huleg/ecstatic-epiphany/photos/2014-04-13 19.56.11.jpg

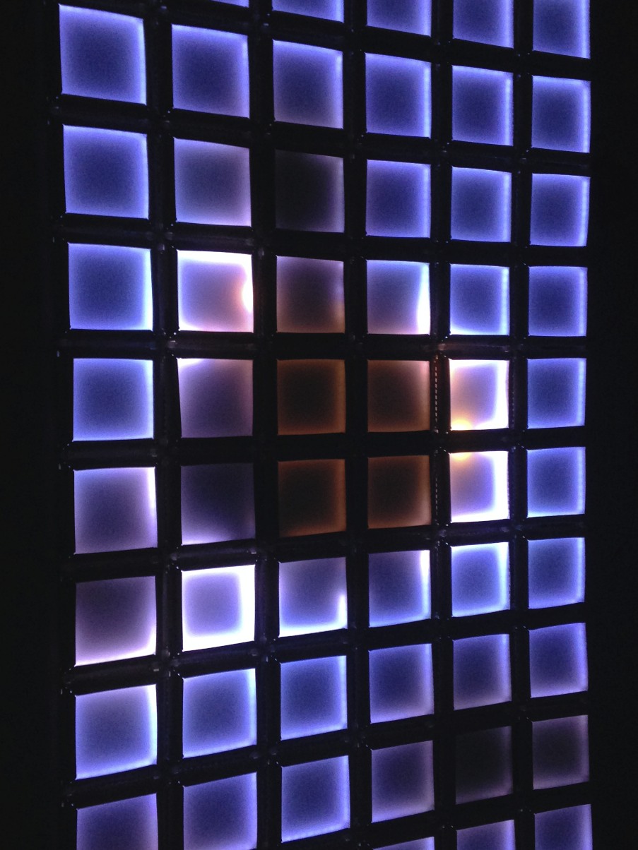
photos/2014-04-13 19.56.11.jpg
