huleg/ecstatic-epiphany/photos/2014-04-15 22.50.10.jpg

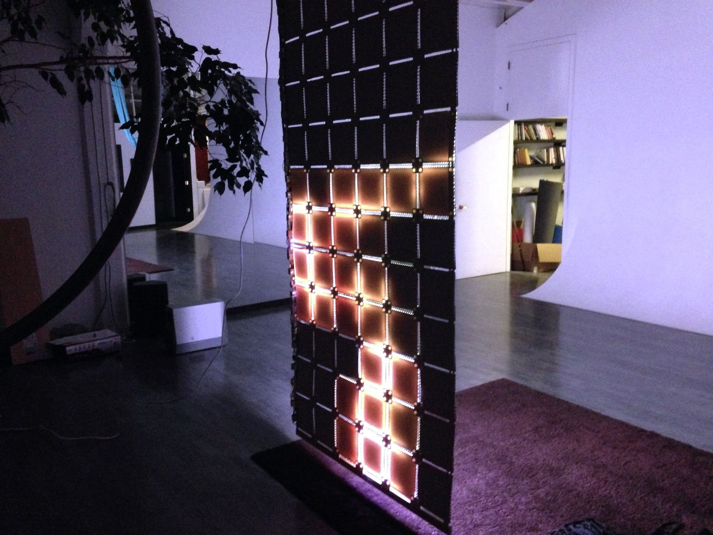
photos/2014-04-15 22.50.10.jpg
