huleg/ecstatic-epiphany/README.md

Ecstatic Epiphany
=================

An interactive light art installation.

2014, Micah Elizabeth Scott

Portfolio link: [misc.name/ecstatic-epiphany](http://www.misc.name/ecstatic-epiphany)
