huleg/ecstatic-epiphany/notes/2014-03-23 12.22.47.jpg

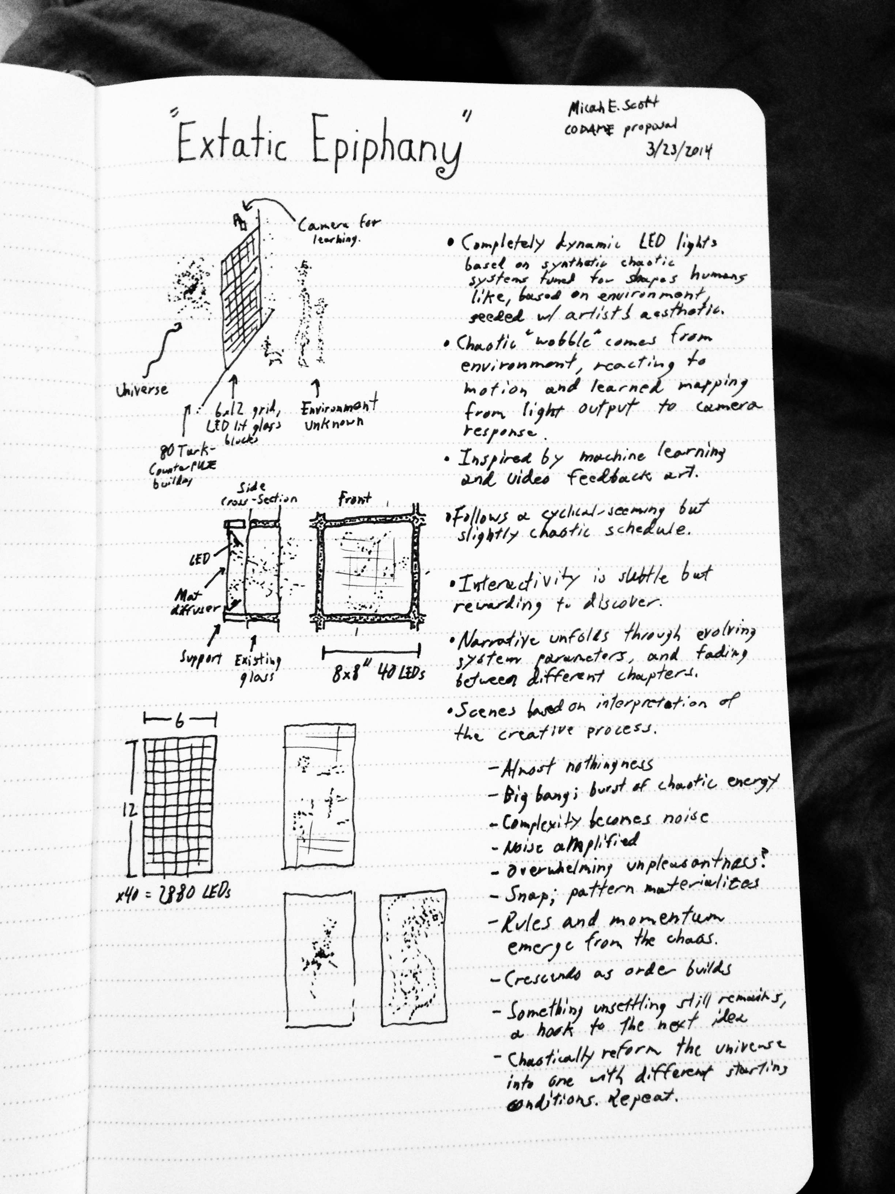
notes/2014-03-23 12.22.47.jpg
