huleg/ecstatic-epiphany/photos/2014-03-28 12.23.55.jpg

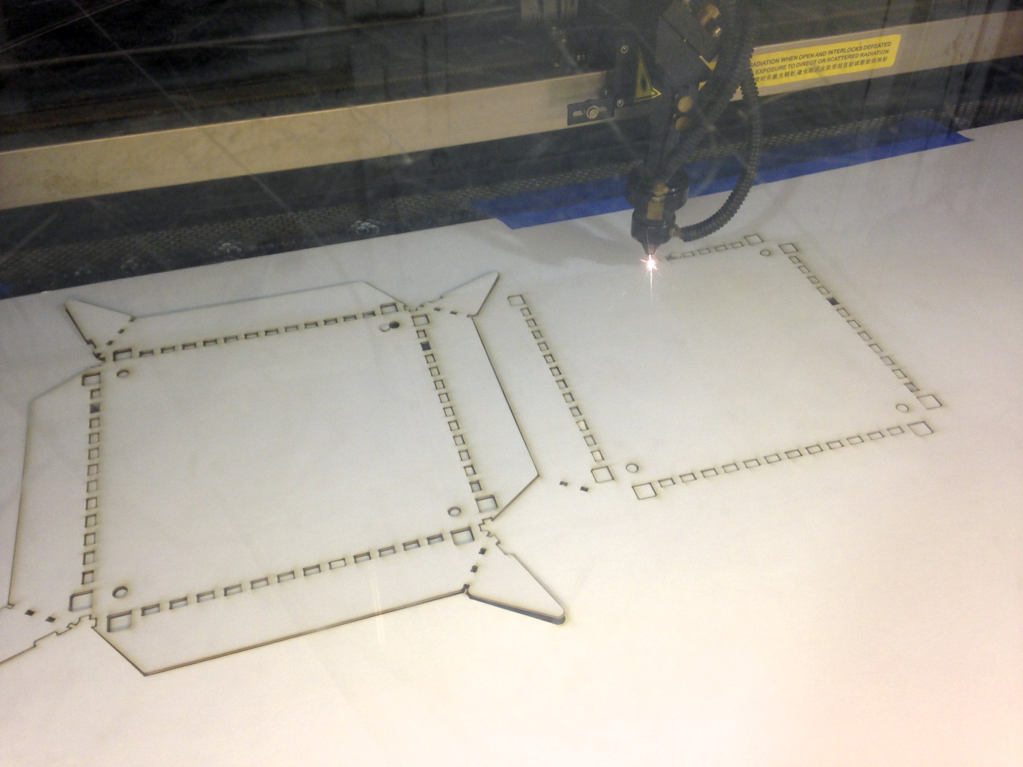
photos/2014-03-28 12.23.55.jpg
