huleg/ecstatic-epiphany/photos/2014-04-05 00.15.27.jpg

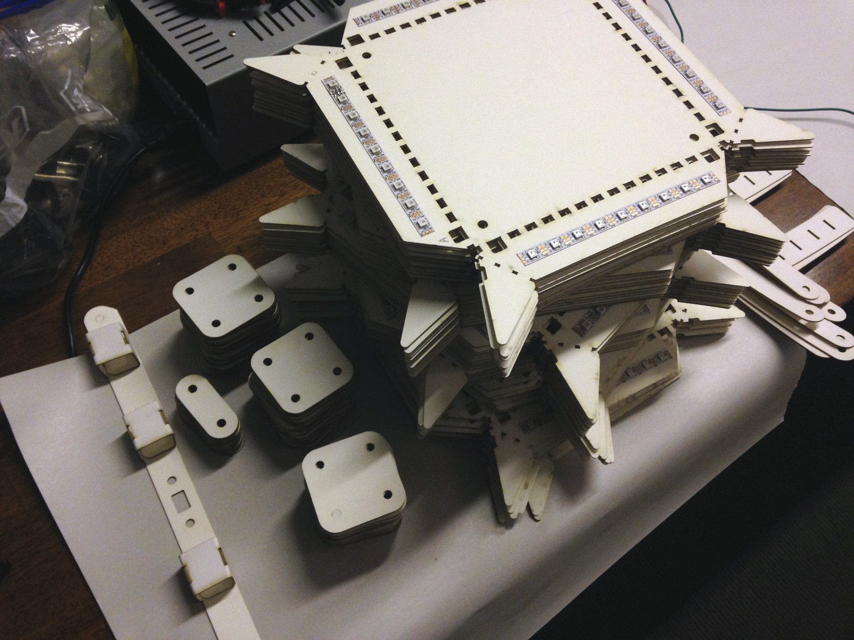
photos/2014-04-05 00.15.27.jpg
