huleg/ecstatic-epiphany/photos/2014-04-05 10.41.52.jpg

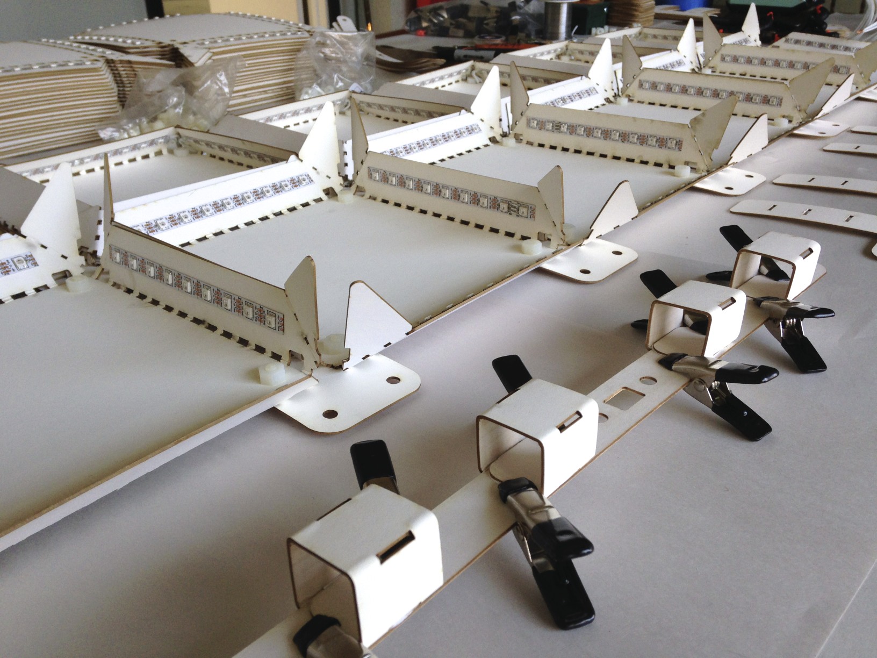
photos/2014-04-05 10.41.52.jpg
