huleg/ecstatic-epiphany/photos/2014-04-06 21.35.55 HDR.jpg

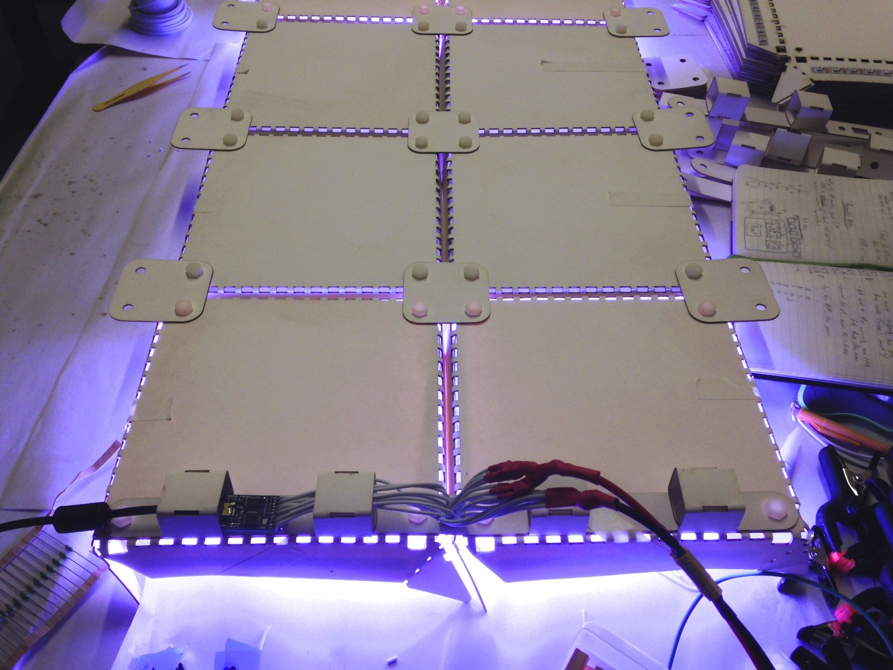
photos/2014-04-06 21.35.55 HDR.jpg
