huleg/ecstatic-epiphany/photos/2014-04-06 23.56.07.jpg

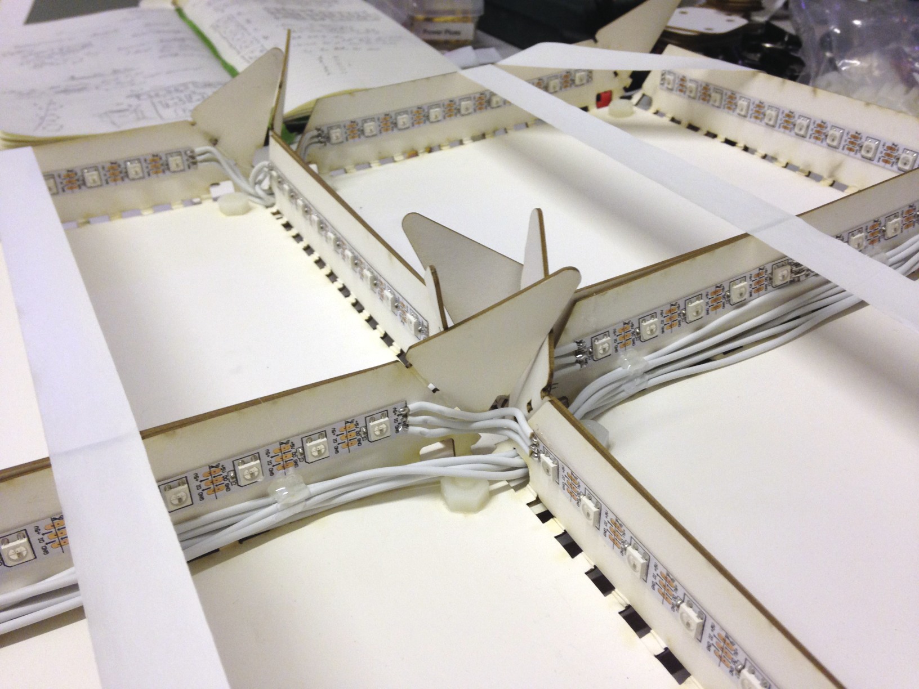
photos/2014-04-06 23.56.07.jpg
