huleg/ecstatic-epiphany/photos/2014-04-07 13.44.34.jpg

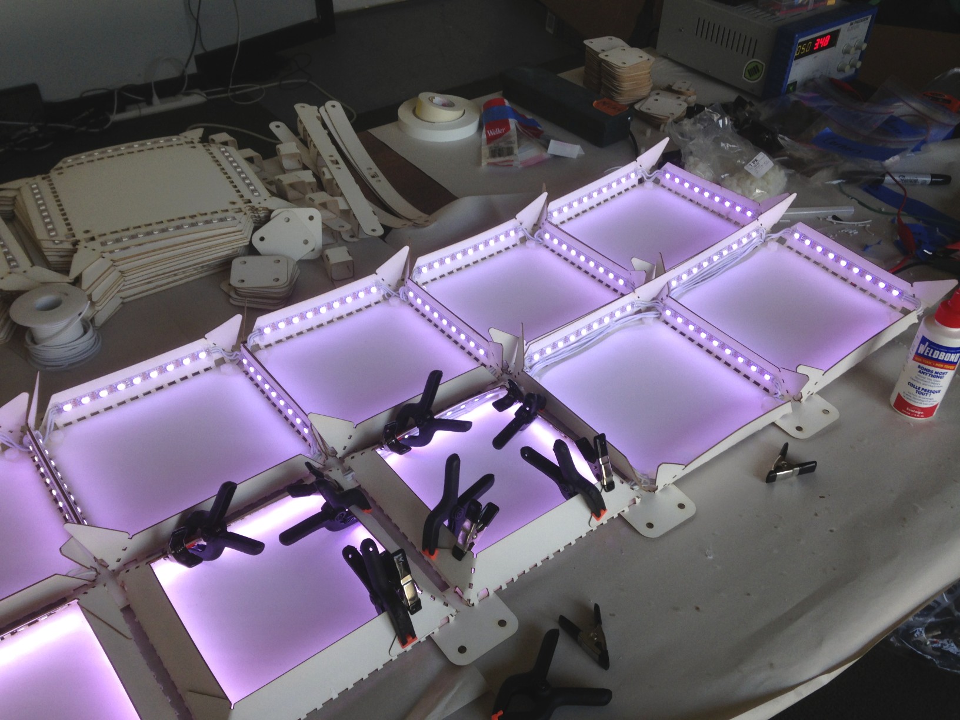
photos/2014-04-07 13.44.34.jpg
