huleg/ecstatic-epiphany/photos/2014-04-08 17.47.04.jpg

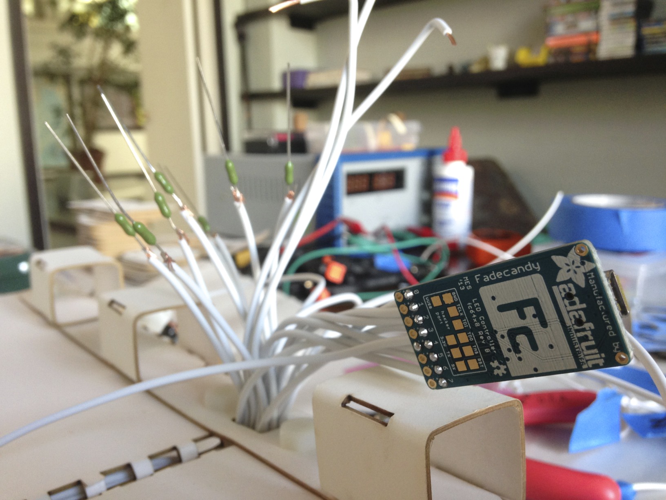
photos/2014-04-08 17.47.04.jpg
