huleg/ecstatic-epiphany/photos/2014-04-14 11.24.55.jpg

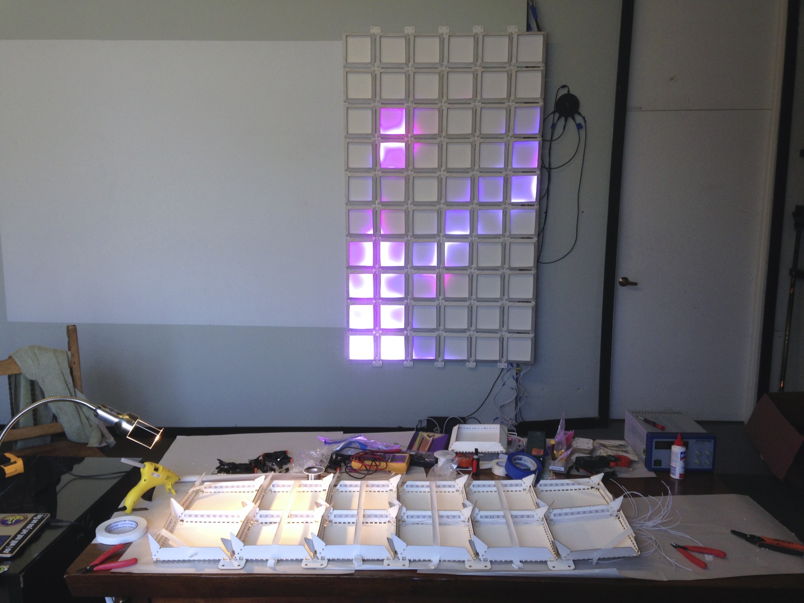
photos/2014-04-14 11.24.55.jpg
