huleg/ecstatic-epiphany/photos/2014-04-15 02.22.39-3.jpg

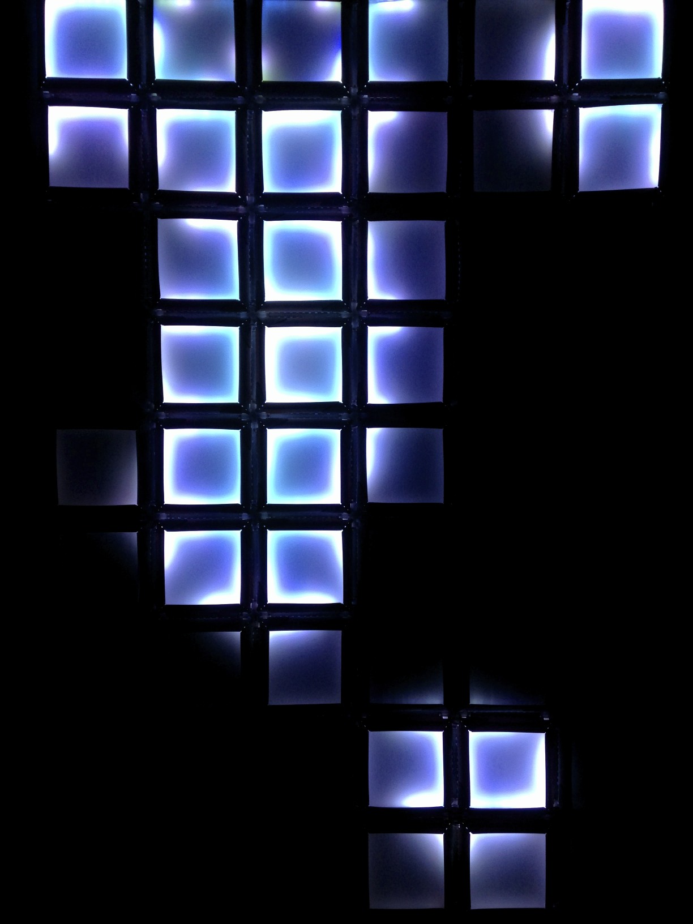
photos/2014-04-15 02.22.39-3.jpg
