huleg/ecstatic-epiphany/photos/2014-04-15 15.28.12.jpg

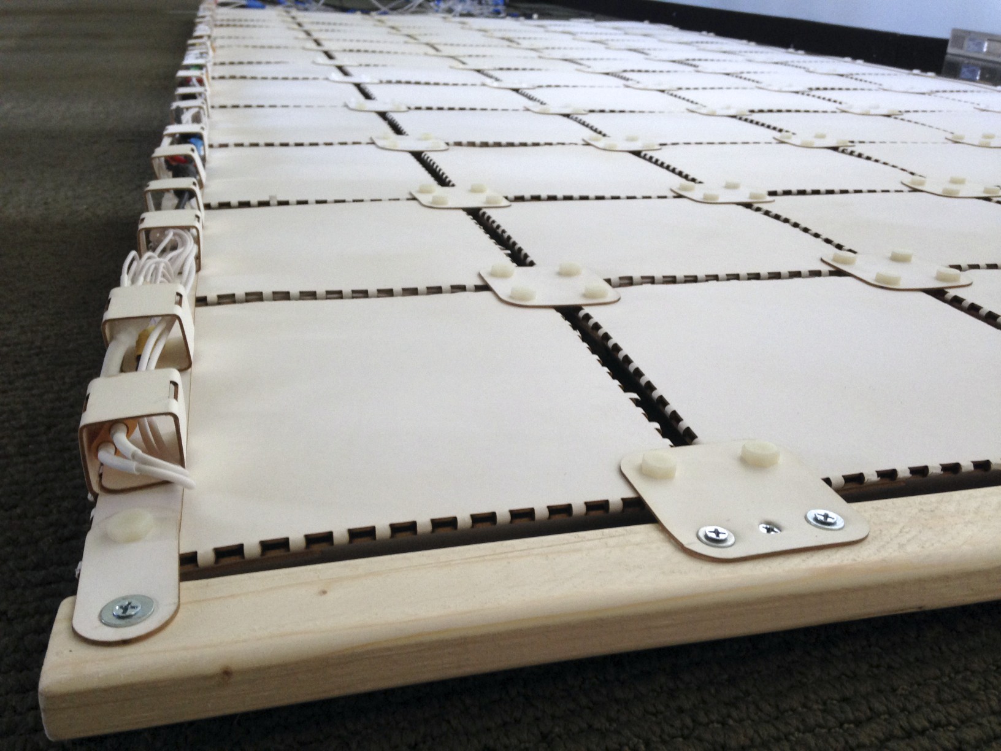
photos/2014-04-15 15.28.12.jpg
