huleg/ecstatic-epiphany/photos/2014-04-16 00.19.34.jpg

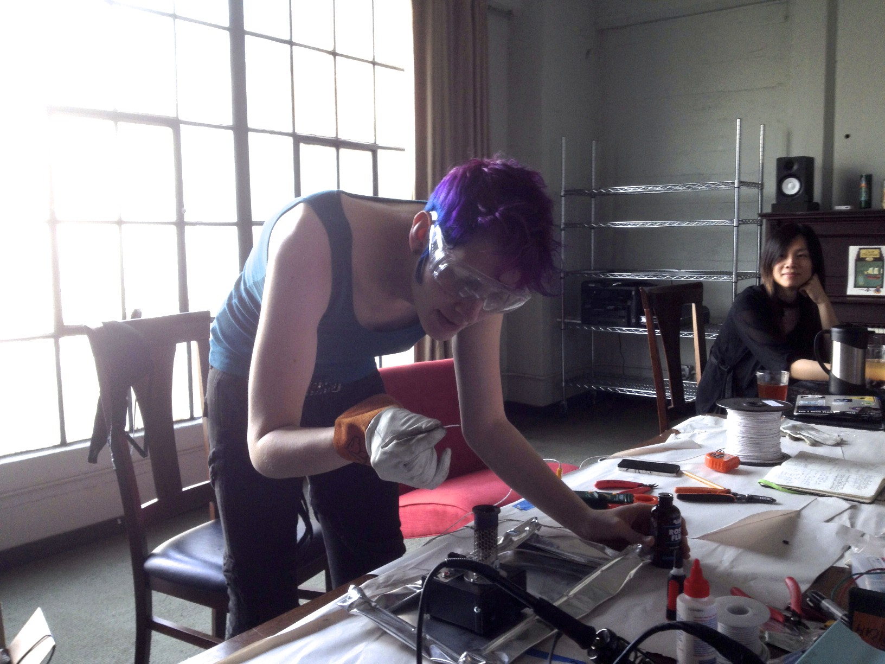
photos/2014-04-16 00.19.34.jpg
