huleg/ecstatic-epiphany/photos/2014-04-16 00.22.21.jpg

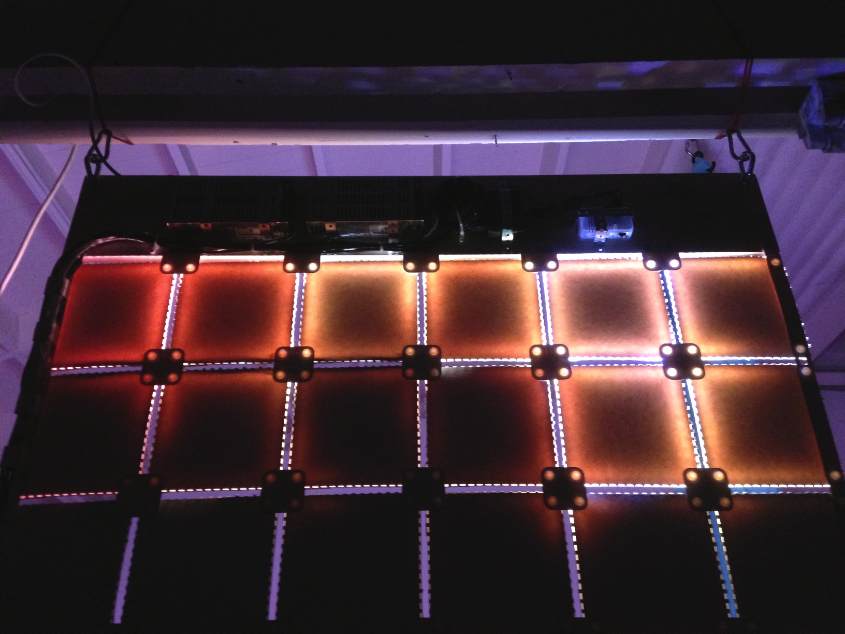
photos/2014-04-16 00.22.21.jpg
