huleg/ecstatic-epiphany/photos/2014-04-16 00.37.34.jpg

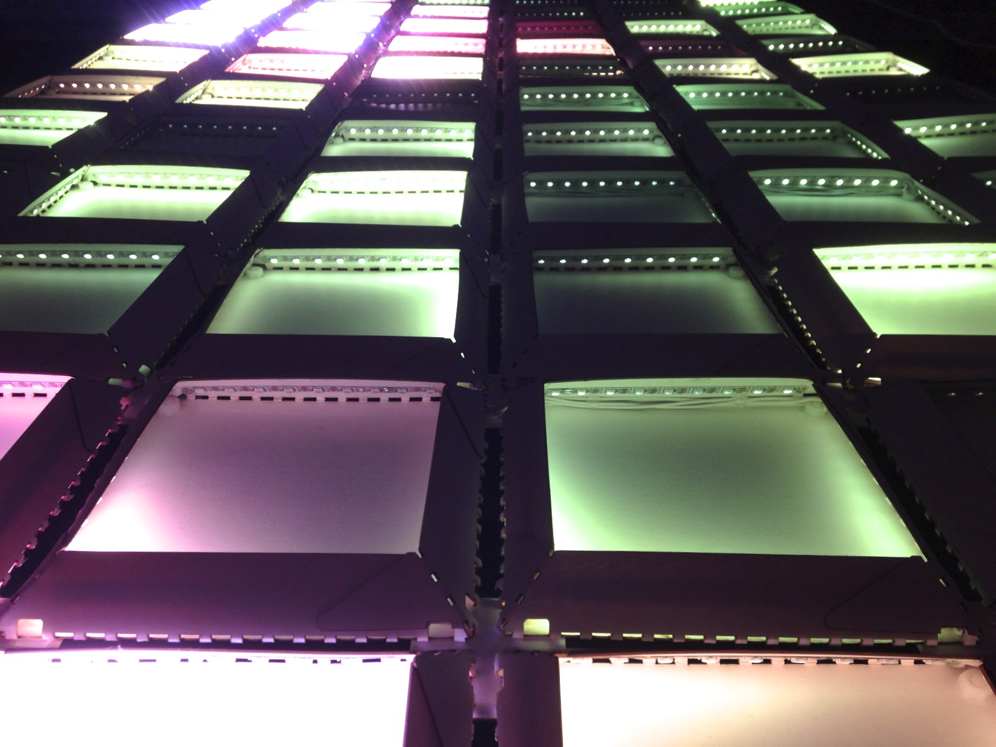
photos/2014-04-16 00.37.34.jpg
