huleg/ecstatic-epiphany/cad/window6x12.SLDASM

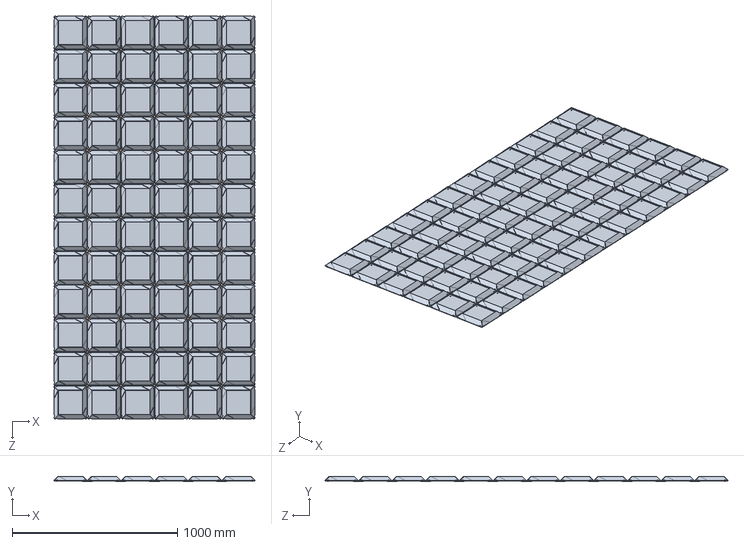
[picture p35: CAD file, 2014-03-27]
cad/window6x12.SLDASM
1214.9 x 30.3 x 2434.1 mm
ecstatic-diffuser-sheet x 72
ecstatic-vertex4 x 55
