huleg/ecstatic-epiphany/cad/ecstatic-edge.SLDPRT

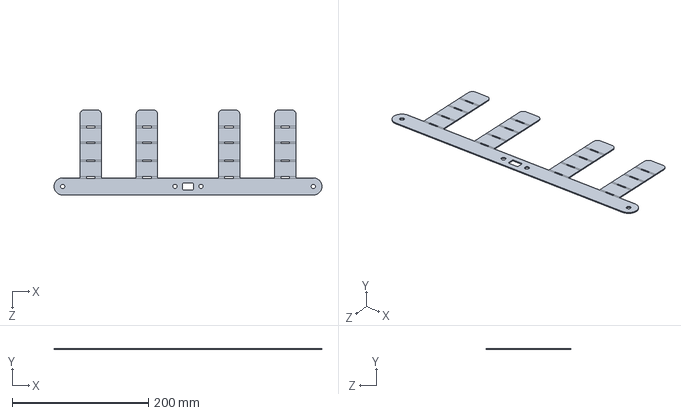
[picture p36: CAD file, 2014-04-04]
cad/ecstatic-edge.SLDPRT
393.7 x 1.40 x 125.1 mm
