huleg/ecstatic-epiphany/cad/ecstatic-vertex2.SLDPRT

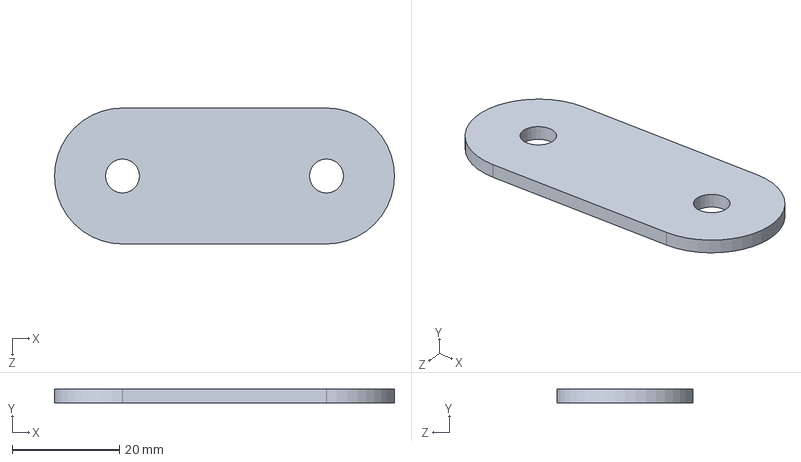
[picture p37: CAD file, 2014-04-04]
cad/ecstatic-vertex2.SLDPRT
63.5 x 2.54 x 25.4 mm
