huleg/ecstatic-epiphany/cad/ecstatic-diffuser-sheet.SLDPRT

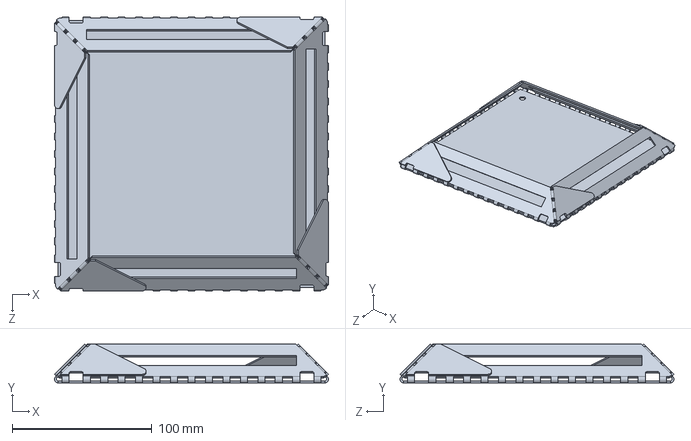
[picture p38: CAD file, 2014-03-27]
cad/ecstatic-diffuser-sheet.SLDPRT
196.1 x 27.8 x 196.1 mm
