huleg/ecstatic-epiphany/cad/ecstatic-vertex4.SLDPRT

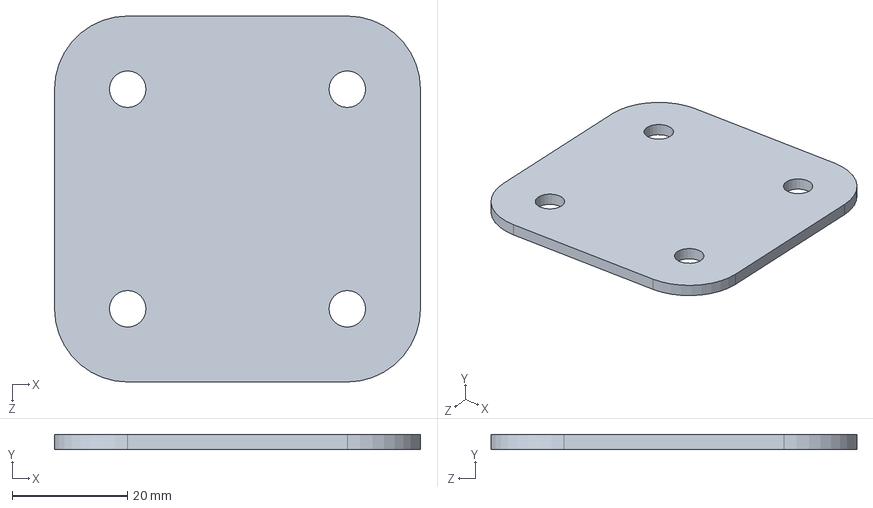
[picture p39: CAD file, 2014-03-27]
cad/ecstatic-vertex4.SLDPRT
63.5 x 2.54 x 63.5 mm
