huleg/ecstatic-epiphany/(commit log)

2014-03-13 Binary blob for somagic NTSC capture device
2014-03-13 Very rough camera driver, based on easycap-somagic-linux
2014-03-13 Camera driver: Bugfixes and cleanup
    [camera.h, camera_somagic.cpp]
2014-03-13 Silly demo, map camera to LEDs using particles
2014-03-13 Move camera into 'lib'
    This is written like library code, and I'll probably reuse it later.
2014-03-13 Tiny and effective JPEG frame grabber
    This listens in on a stream of VideoChunks, keeping track of them
    in a framebuffer. A state machine supports grabbing intact frames
    and compressing them to JPEG using the tiny jpge library.
2014-03-13 Periodic frame grabber, start work on visual memory
2014-03-13 Sampler block accessors
    Convenient accessors for calculating block x/y address in sampler
2014-03-13 More progress on VisualMemory
    This is starting to produce sensible maps of its environment!
    Next up, dedicated learning thread so we don't drop isochronous
    packets.
2014-03-13 Synchronized grab of video frame and VisualMemory debug
2014-03-13 Still experimenting with VisualMemory algorithm
    Try continuous learning in a separate thread, so as not to drop isoc packets.
    Smoothing is behaving badly still.
2014-03-15 Latency timer tool
2014-03-17 EffectTap bug fix, don't return invalid frames
2014-03-17 Performance tweaks for VisualMemory on 512 LEDs
2014-03-17 Debug thread, so memory dumps don't block animation
2014-03-17 More frobbing the reaction filters
2014-03-18 Tolerance buildup, for subtracting steady-state from recall buffer
    [visualmemory.h]
2014-03-18 Recall filtering looks promising!
2014-03-18 More recall filtering work
2014-03-18 More tweaks for recall filtering
2014-03-18 Experimenting with Gabor kernels
    This isn't really working.. too much CPU. Will probably simplify this into a Sobel detector.
    [main.cpp]
2014-03-18 Sobel filter for motion detection
2014-03-18 More tweaks, learning still getting stuck in bimodal oscillations
    [main.cpp]
2014-03-19 Recall filtering
2014-03-19 Explicit covariance calculation, expected value filters
2014-03-19 Fix debug rendering for models with more than 768 LEDs
    [main.cpp]
2014-03-19 Filter for recallScale
    This makes the whole thing a lot less numerically unstable...
    [main.cpp]
2014-03-19 More recall filtering
    There's some osciallation happening; was assuming it was coming in through the camera, but now I'm wondering if it's in the filter itself. More investigation needed...
2014-03-19 Leaky peak detector for filtering motion thresholds
2014-03-26 Starting work on CAD design for laser-cut parts
    [folded-diffuser.SLDPRT]
2014-03-27 CAD files for first laser-cut prototype
    [ecstatic-diffuser-dotted.dxf, folded-diffuser.SLDPRT]
2014-03-27 Work in progress, new diffuser using sheet metal mode
    [ecstatic-diffuser-sheet.SLDPRT]
2014-03-27 New "sheet metal" version of the diffuser
    [ecstatic-diffuser-dotted.dxf, ecstatic-diffuser-sheet.SLDPRT, folded-diffuser.SLDPRT]
2014-03-27 New rev ready to lasercut
    [ecstatic-diffuser-sheet.SLDPRT]
2014-03-27 CAD files for vertex and assembly
    [ecstatic-vertex4.SLDPRT, window6x12.SLDASM]
2014-03-27 Laser cut mat sheet for testing, 6 diffusers
    [ecstatic-diffuser-sheet.SLDPRT, ecstatic-vertex4.SLDPRT]
2014-03-30 Palette swap for rings
    [main.cpp]
2014-04-03 New LED strip layout
2014-04-04 More CAD work; vertex2, edge
    [ecstatic-edge.SLDPRT, ecstatic-vertex2.SLDPRT]
2014-04-04 Bottom half of each LED module is mirrored vertically, to optimize wiring
2014-04-07 Permissions for camera libusb device
2014-04-09 3rd FC board
2014-04-11 Fourth fc board
2014-04-11 Monitor fcserver with supervisord
    There is some libusb hotplug bug which causes occasional segfaults when unplugging a device; workaround by having supervisor auto-restart fcserver
2014-04-11 Remove unused debug thread
2014-04-11 Disable SDL and camera, for debugging sanity
2014-04-11 Retune ChaosParticles for longer runtime (need to verify on LEDs still)
2014-04-14 Serial for the last fc board
2014-04-23 Cut Ants
2014-04-23 Darken slightly, to decrease power usage spike leading to reboot
2014-04-23 Turn camera driver on
2014-04-23 Starting work on optical flow; currently still way too slow
    [main.cpp]
2014-04-25 Sparse optical flow kinda working
2014-04-26 More Precursor flow interaction work
2014-04-26 Give unmapped LEDs a reliable 'point' value
2014-04-26 Less Y axis stretching
2014-04-26 Start pulling config data from a JSON file
    So tired of recompiling to tweak parameter values.
2014-04-27 More configurability, camera parameter hacking
2014-04-28 Flow tweaking, improve Precursor performance, better debug output
2014-04-29 Camera parameter tweaks
2014-04-29 More camera tweaking
2014-04-29 Real-time priority for camera thread
2014-05-01 Keep track of variation in timeDelta (jitter)
2014-05-01 Fewer index rebuilds per frame in order-particles
    A little less accurate, but potentially lots faster
2014-05-01 Remove real-time scheduling
    This helped the camera underrun less, but in return the LED performance was terrible- jitter into the tens of milliseconds. Without any RT threads, the LED timing is much more consistent
2014-05-01 No reason not to use more iso transfers
    Maybe drop frames less
2014-05-01 Smoother flow for chaos-particles
2014-05-02 Spurious particle launch for tree-growth, even without a camera
2014-05-02 Gradual rampup for flowScale in chaos-particles, to avoid abrupt discontinuity
2014-05-04 Reset flow origin when reseeding chaos-particles
2016-05-31 Switch to clang for linux builds gcc was crashing, blah.
